nit1995/reimagined-enigma/Prototype/PCB/MEGA_2560 BOARD/CAMOutputs/Assembly/PnP_Motherboard Schematics - 1 - 29_Dec_2020_front.txt

C12	124.84	44.83	90.00		C1206
C13	125.35	26.29	180.00		C1206
C16	124.33	8.64	90.00		C1206
C17	124.33	-9.27	180.00		C1206
C19	127.00	-19.56	0.00		C1206
C2	123.11	40.26	0.00		C1206
C22	120.62	49.53	0.00	0.1uF	C1206
C23	117.75	34.93	0.00	0.1uF	C1206
C26	118.11	10.29	0.00		C1206
C27	120.65	-1.40	0.00		C1206
C29	115.82	-22.23	0.00		C1206
C3	125.32	30.61	270.00		C1206
C39	36.07	-15.75	90.00	0.1uF	C1206
C6	117.98	5.46	0.00		C1206
C7	129.03	-9.14	270.00		C1206
C79	36.20	-21.59	90.00	0.1uF	C1206
C9	116.08	-17.65	0.00		C1206
C90	11.81	33.76	270.00	0.1uF	C1206
D12	121.97	44.88	90.00	1N4148W	DO214AC
D13	121.29	27.69	90.00	1N4148W	DO214AC
D16	122.00	9.75	90.00	1N4148W	DO214AC
D18	119.96	-9.42	270.00	1N4148W	DO214AC
D19	127.89	-16.05	0.00	1N4148W	DO214AC
D2	126.42	37.67	180.00	1N4148W	DO214AC
D3	120.75	32.46	0.00	1N4148W	DO214AC
D6	124.46	4.29	0.00	1N4148W	DO214AC
D7	124.66	-12.14	180.00	1N4148W	DO214AC
D9	118.29	-15.14	0.00	1N4148W	DO214AC
LED1	43.15	-28.30	90.00		CHIPLED_1206
LED10	13.00	16.89	90.00		CHIPLED_1206
LED11	26.64	45.34	90.00		CHIPLED_1206
LED12	18.39	40.21	90.00		CHIPLED_1206
LED13	120.40	79.63	0.00		CHIPLED_1206
LED14	128.14	91.82	0.00		CHIPLED_1206
LED15	110.49	92.20	270.00		CHIPLED_1206
LED16	103.76	61.09	270.00		CHIPLED_1206
LED2	51.94	-10.11	270.00		CHIPLED_1206
LED3	49.40	6.22	90.00		CHIPLED_1206
LED4	39.07	6.05	90.00		CHIPLED_1206
LED5	38.53	11.81	90.00		CHIPLED_1206
LED6	48.87	21.89	90.00		CHIPLED_1206
LED7	37.85	35.31	90.00		CHIPLED_1206
LED8	49.40	35.31	90.00		CHIPLED_1206
LED9	20.27	18.19	180.00		CHIPLED_1206
R12	119.38	44.32	90.00	1k	R1206
R13	116.18	30.35	90.00	1k	R1206
R16	118.11	8.13	180.00	1k	R1206
R17	120.02	-4.57	180.00	1k	R1206
R19	116.08	-19.94	180.00	1k	R1206
R2	127.25	45.09	270.00	1k	R1206
R22	129.67	45.09	90.00	10k	R1206
R23	130.02	30.45	90.00	10k	R1206
R26	128.91	8.64	90.00	10k	R1206
R27	125.98	-5.59	90.00	10k	R1206
R3	127.76	30.61	270.00	1k	R1206
R30	121.79	-19.81	180.00	10k	R1206
R32	43.51	-25.73	180.00	10k	R1206
R34	38.99	-11.94	0.00	10k	R1206
R35	57.56	-10.01	0.00	10k	R1206
R36	57.58	-5.79	180.00	10k	R1206
R37	42.72	-6.71	180.00	10k	R1206
R39	49.10	9.47	180.00	10k	R1206
R40	42.16	23.29	180.00	10k	R1206
R42	31.47	24.23	90.00	10k	R1206
R43	21.64	11.30	270.00	10k	R1206
R44	32.74	29.97	270.00	10k	R1206
R47	47.83	-11.63	270.00	10k	R1206
R50	53.59	7.62	90.00	10k	R1206
R53	44.20	7.49	270.00	10k	R1206
R56	38.61	9.14	180.00	10k	R1206
R59	54.18	21.89	0.00	10k	R1206
R6	126.49	8.64	270.00	1k	R1206
R62	43.31	35.31	0.00	10k	R1206
R65	49.61	37.67	180.00	10k	R1206
R68	13.00	19.41	180.00	10k	R1206
R7	123.70	-5.46	270.00	1k	R1206
R71	17.17	17.91	90.00	10k	R1206
R74	31.98	45.31	0.00	10k	R1206
R77	22.40	41.12	90.00	10k	R1206
R79	123.57	79.38	90.00	1k	R1206
R80	131.06	91.82	90.00	1k	R1206
R81	105.92	90.68	270.00	1k	R1206
R83	97.16	61.21	180.00	1k	R1206
R9	121.79	-17.65	0.00	1k	R1206
