nit1995/reimagined-enigma/Prototype/PCB/MEGA_2560 BOARD/CAMOutputs/Assembly/Motherboard Schematics - 1 - 29_Dec_2020.txt

Partlist exported from G:/vinay projects/MEGA_2560 BOARD/Motherboard Schematics - 1 - 29_Dec_2020.sch at 05-01-2021 00:07

Qty Value                               Device                              Package                                   Parts                                                                                                                                                                                                                                                                                            Description                                                             ARROW_PART_NUMBER ARROW_PRICE-STOCK                                             AVAILABILITY DESCRIPTION                                                                                                  HEIGHT MANUFACTURER_NAME MANUFACTURER_PART_NUMBER MF       MOUSER_PART_NUMBER MOUSER_PRICE-STOCK                                                                     MP                                 MPN          OC_FARNELL OC_NEWARK PACKAGE  POPULARITY PRICE PURCHASE-URL                                                SPICEPREFIX
1                                       10-XX                               B3F-10XX                                  RESET_SW                                                                                                                                                                                                                                                                                         OMRON SWITCH                                                                                                                                                                                                                                                                                                                                                                                                                                                                              B3F-1000     176432     36M3542            72                                                                                      
25                                      C-EUC1206                           C1206                                     C1, C2, C3, C4, C5, C6, C7, C8, C9, C10, C11, C12, C13, C14, C15, C16, C17, C18, C19, C20, C26, C27, C28, C29, C30                                                                                                                                                                               CAPACITOR, European symbol                                                                                                                                                                                                                                                                                                                                                                                                                                                                                                           54                                                                           C          
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
7   220uF                               CPOL-EUE5-10.5                      E5-10,5                                   C32, C36, C40, C60, C75, C76, C77                                                                                                                                                                                                                                                                POLARIZED CAPACITOR, European symbol                                                                                                                                                                                                                                                                                                                                                                                                                                                                                                 23                                                                           C          
9   5mmTerminal_Block                   TERMINAL-BLOCK-3.5MM-2-PIN-LONG-PAD TERMINAL-BLOCK-2-PIN-3.5MM-LONG-PAD       X1, X2, X3, X6, X7, X8, X9, X10, X11                                                                                                                                                                                                                                                             Terminal Block 3.5mm                                                                                                                                                                                                                                                                                                                                                                                                                                                                                                                                                                                                         
2   7805DT                              7805DT                              TO252                                     IC2, IC3                                                                                                                                                                                                                                                                                         Positive VOLTAGE REGULATOR                                                                                                                                                                                                                                                                                                                                                                                                                                                                                                           0                                                                                       
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
12  MCT2E                               MCT2E                               DIP762W60P254L712H480Q6N                  IC1, IC4, IC5, IC6, IC7, IC8, IC9, IC10, IC11, IC12, IC13, IC14                                                                                                                                                                                                                                  Transistor Output Optocouplers Optocouplers                             MCT2E             https://www.arrow.com/en/products/mct2e/everlight-electronics              Transistor Output Optocouplers Optocouplers                                                                  4.8mm  Everlight         MCT2E                             638-MCT2E          https://www.mouser.co.uk/ProductDetail/Everlight/MCT2E?qs=8PzhAHr7IdNay24oEWwF1g%3D%3D                                                                                                                                                                       
1   MEGA_PRO_EMBED_CH340G_/_ATMEGA2560  MEGA_PRO_EMBED_CH340G_/_ATMEGA2560  MODULE_MEGA_PRO_EMBED_CH340G_/_ATMEGA2560 U1                                                                                                                                                                                                                                                                                               Mega 2560 PRO (Embed) CH340G/ATmega2560-16AU                                                                                                            Unavailable                                                                                                                                                                 Robotdyn                                                                                                           Mega Pro Embed CH340G / ATmega2560                                   Package             None                                                                         
1   RS485-TTL-CONVERTER                 RS485-TTL-CONVERTER                 RS485-TTL-CONVERTER                       U$2                                                                                                                                                                                                                                                                                              RS485 to TTL converter based on MAX485 chip                                                                                                                                                                                                                                                                                                                                                                                                                                                                                                                                                                                  
1   RTC-DS3231-AT24C32                  RTC-DS3231-AT24C32                  RTC-DS3231-AT24C32                        U$1                                                                                                                                                                                                                                                                                              RTC Module with Battery and EEPROM based on DS3231 and AT24C32 chips                                                                                                                                                                                                                                                                                                                                                                                                                                                                                                                                                         
1   SPPH410100                          SPPH410100                          SPPH410100                                SW                                                                                                                                                                                                                                                                                               Check prices                                                                                                                                            Good          Ring Type Encoder (ABC - three phase) • Number of Detent: 30 • Number of Pulse: 10 • Actuator Length: 15mm                                                    ALPS                                                                                                               SPPH410100                                                           None                None  https://pricing.snapeda.com/search/part/SPPH410100/?ref=eda            
1   SWITCH_I                            SWITCH_I                            SWITCH_I                                  SWITCH                                                                                                                                                                                                                                                                                                                                                                                                                                                                                                                                                                                                                                                                                                                                                                                                                                                                                                                        
8   TERMINAL-BLOCK-3.5MM-2-PIN-LONG-PAD TERMINAL-BLOCK-3.5MM-2-PIN-LONG-PAD TERMINAL-BLOCK-2-PIN-3.5MM-LONG-PAD       X5, X12, X13, X14, X15, X16, X17, X18                                                                                                                                                                                                                                                            Terminal Block 3.5mm                                                                                                                                                                                                                                                                                                                                                                                                                                                                                                                                                                                                         
1   TERMINAL_BLOCK                      TERMINAL_BLOCK                      BOC_TERMINAL                              T1
