nit1995/reimagined-enigma/Prototype/PCB/MEGA_2560 BOARD/Image_bottomlayer.png

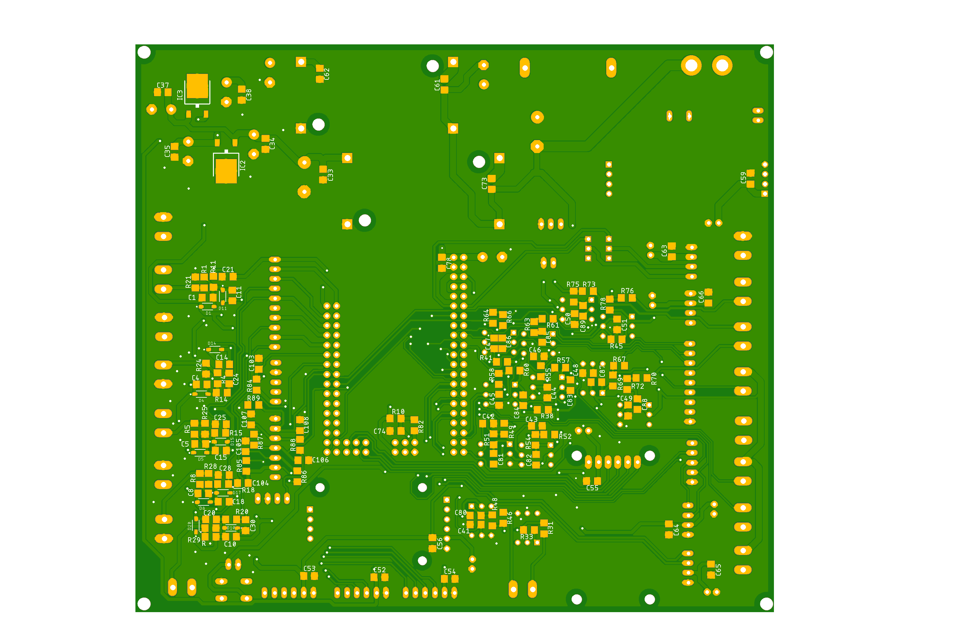
Prototype/PCB/MEGA_2560 BOARD/Image_bottomlayer.png
