nit1995/reimagined-enigma/Prototype/PCB/MEGA_2560 BOARD/image_toplayer.png

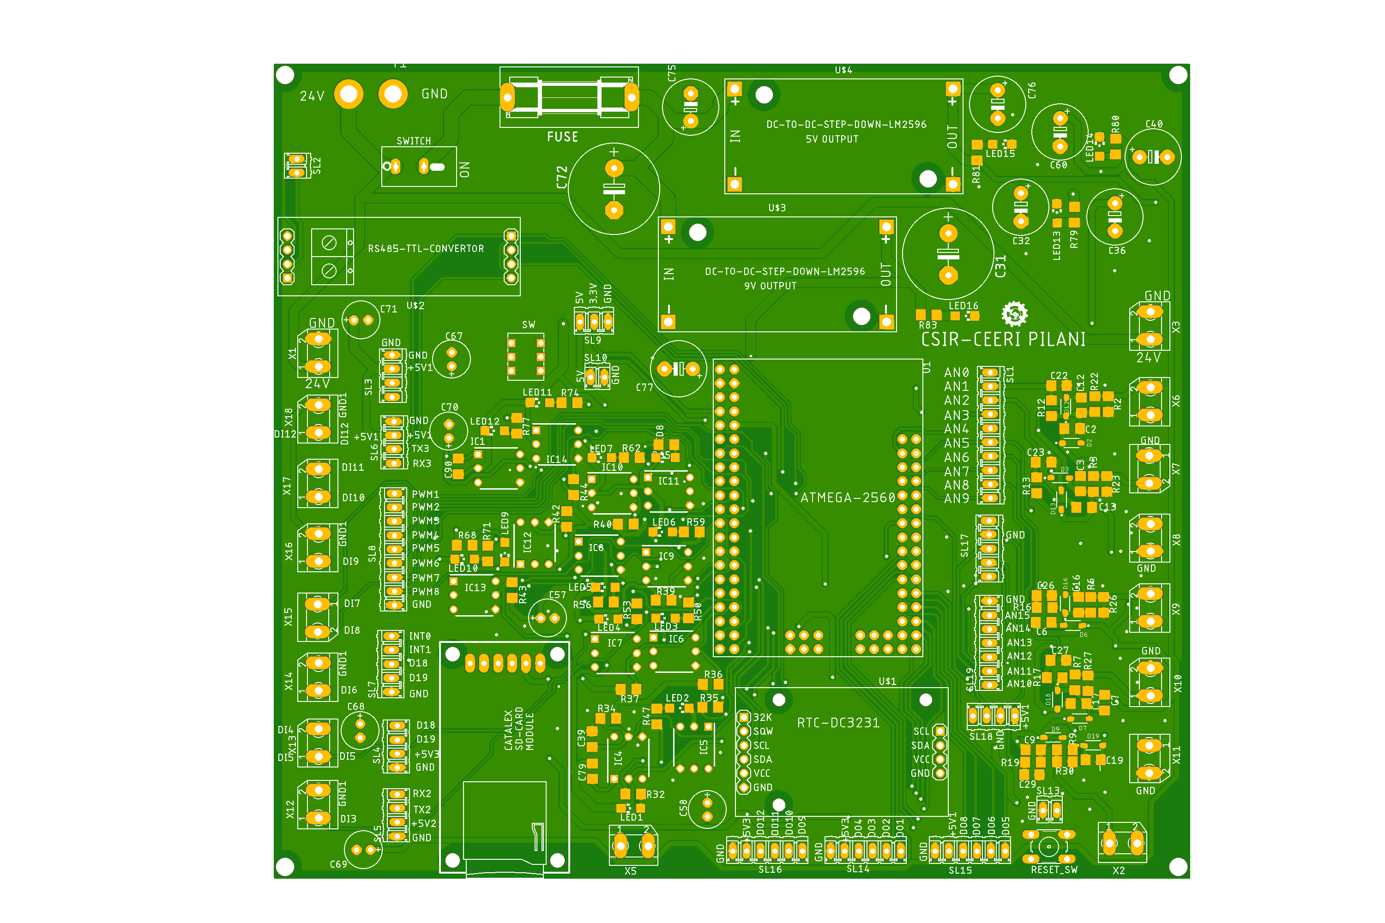
Prototype/PCB/MEGA_2560 BOARD/image_toplayer.png
