nit1995/reimagined-enigma/Prototype/PCB/MEGA_2560 BOARD/BOM 28-1-21.csv

Part | Value | Device | Package | Description | ARROW_PART_NUMBER | ARROW_PRICE-STOCK | AVAILABILITY | DESCRIPTION | HEIGHT | MANUFACTURER_NAME | MANUFACTURER_PART_NUMBER | MF | MOUSER_PART_NUMBER | MOUSER_PRICE-STOCK | MP | MPN | OC_FARNELL | OC_NEWARK | PACKAGE | POPULARITY | PRICE | PURCHASE-URL | SPICEPREFIX
C1 |  | C-EUC1206 | C1206 | CAPACITOR, European symbol |  |  |  |  |  |  |  |  |  |  |  |  |  |  |  | 54 |  |  | C
C2 |  | C-EUC1206 | C1206 | CAPACITOR, European symbol |  |  |  |  |  |  |  |  |  |  |  |  |  |  |  | 54 |  |  | C
C3 |  | C-EUC1206 | C1206 | CAPACITOR, European symbol |  |  |  |  |  |  |  |  |  |  |  |  |  |  |  | 54 |  |  | C
C4 |  | C-EUC1206 | C1206 | CAPACITOR, European symbol |  |  |  |  |  |  |  |  |  |  |  |  |  |  |  | 54 |  |  | C
C5 |  | C-EUC1206 | C1206 | CAPACITOR, European symbol |  |  |  |  |  |  |  |  |  |  |  |  |  |  |  | 54 |  |  | C
C6 |  | C-EUC1206 | C1206 | CAPACITOR, European symbol |  |  |  |  |  |  |  |  |  |  |  |  |  |  |  | 54 |  |  | C
C7 |  | C-EUC1206 | C1206 | CAPACITOR, European symbol |  |  |  |  |  |  |  |  |  |  |  |  |  |  |  | 54 |  |  | C
C8 |  | C-EUC1206 | C1206 | CAPACITOR, European symbol |  |  |  |  |  |  |  |  |  |  |  |  |  |  |  | 54 |  |  | C
C9 |  | C-EUC1206 | C1206 | CAPACITOR, European symbol |  |  |  |  |  |  |  |  |  |  |  |  |  |  |  | 54 |  |  | C
C10 |  | C-EUC1206 | C1206 | CAPACITOR, European symbol |  |  |  |  |  |  |  |  |  |  |  |  |  |  |  | 54 |  |  | C
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
C105 | 0.1uF | C-EUC1206 | C1206 | CAPACITOR, European symbol |  |  |  |  |  |  |  |  |  |  |  |  |  |  |  | 54 |  |  | C
C106 | 0.1uF | C-EUC1206 | C1206 | CAPACITOR, European symbol |  |  |  |  |  |  |  |  |  |  |  |  |  |  |  | 54 |  |  | C
C107 | 0.1uF | C-EUC1206 | C1206 | CAPACITOR, European symbol |  |  |  |  |  |  |  |  |  |  |  |  |  |  |  | 54 |  |  | C
C108 | 0.1uF | C-EUC1206 | C1206 | CAPACITOR, European symbol |  |  |  |  |  |  |  |  |  |  |  |  |  |  |  | 54 |  |  | C
D1 | 1N4148W | DIODE-DO214AC | DO214AC | DIODE |  |  |  |  |  |  |  |  |  |  |  |  |  |  |  | 14
D2 | 1N4148W | DIODE-DO214AC | DO214AC | DIODE |  |  |  |  |  |  |  |  |  |  |  |  |  |  |  | 14
D3 | 1N4148W | DIODE-DO214AC | DO214AC | DIODE |  |  |  |  |  |  |  |  |  |  |  |  |  |  |  | 14
D4 | 1N4148W | DIODE-DO214AC | DO214AC | DIODE |  |  |  |  |  |  |  |  |  |  |  |  |  |  |  | 14
D5 | 1N4148W | DIODE-DO214AC | DO214AC | DIODE |  |  |  |  |  |  |  |  |  |  |  |  |  |  |  | 14
D6 | 1N4148W | DIODE-DO214AC | DO214AC | DIODE |  |  |  |  |  |  |  |  |  |  |  |  |  |  |  | 14
D7 | 1N4148W | DIODE-DO214AC | DO214AC | DIODE |  |  |  |  |  |  |  |  |  |  |  |  |  |  |  | 14
D8 | 1N4148W | DIODE-DO214AC | DO214AC | DIODE |  |  |  |  |  |  |  |  |  |  |  |  |  |  |  | 14
D9 | 1N4148W | DIODE-DO214AC | DO214AC | DIODE |  |  |  |  |  |  |  |  |  |  |  |  |  |  |  | 14
D10 | 1N4148W | DIODE-DO214AC | DO214AC | DIODE |  |  |  |  |  |  |  |  |  |  |  |  |  |  |  | 14
D11 | 1N4148W | DIODE-DO214AC | DO214AC | DIODE |  |  |  |  |  |  |  |  |  |  |  |  |  |  |  | 14
D12 | 1N4148W | DIODE-DO214AC | DO214AC | DIODE |  |  |  |  |  |  |  |  |  |  |  |  |  |  |  | 14
D13 | 1N4148W | DIODE-DO214AC | DO214AC | DIODE |  |  |  |  |  |  |  |  |  |  |  |  |  |  |  | 14
D14. | 1N4148W | DIODE-DO214AC | DO214AC | DIODE |  |  |  |  |  |  |  |  |  |  |  |  |  |  |  | 14
D15 | 1N4148W | DIODE-DO214AC | DO214AC | DIODE |  |  |  |  |  |  |  |  |  |  |  |  |  |  |  | 14
D16 | 1N4148W | DIODE-DO214AC | DO214AC | DIODE |  |  |  |  |  |  |  |  |  |  |  |  |  |  |  | 14
D17 | 1N4148W | DIODE-DO214AC | DO214AC | DIODE |  |  |  |  |  |  |  |  |  |  |  |  |  |  |  | 14
D18 | 1N4148W | DIODE-DO214AC | DO214AC | DIODE |  |  |  |  |  |  |  |  |  |  |  |  |  |  |  | 14
D19 | 1N4148W | DIODE-DO214AC | DO214AC | DIODE |  |  |  |  |  |  |  |  |  |  |  |  |  |  |  | 14
D20 | 1N4148W | DIODE-DO214AC | DO214AC | DIODE |  |  |  |  |  |  |  |  |  |  |  |  |  |  |  | 14
FUSE |  | SH22,5A | SH22,5A | FUSE HOLDER grid 22,5mm, isolated cap OGN0031 8201, Schurter (Buerklin) |  |  |  |  |  |  |  |  |  |  |  | 0031.7701.11 | unknown | 04F1224 |  | 0
IC1 | MCT2E | MCT2E | DIP762W60P254L712H480Q6N | Transistor Output Optocouplers Optocouplers | MCT2E | https://www.arrow.com/en/products/mct2e/everlight-electronics |  | Transistor Output Optocouplers Optocouplers | 4.8mm | Everlight | MCT2E |  | 638-MCT2E | https://www.mouser.co.uk/ProductDetail/Everlight/MCT2E?qs=8PzhAHr7IdNay24oEWwF1g%3D%3D
IC2 | 7805DT | 7805DT | TO252 | Positive VOLTAGE REGULATOR |  |  |  |  |  |  |  |  |  |  |  |  |  |  |  | 0
IC3 | 7805DT | 7805DT | TO252 | Positive VOLTAGE REGULATOR |  |  |  |  |  |  |  |  |  |  |  |  |  |  |  | 0
IC4 | MCT2E | MCT2E | DIP762W60P254L712H480Q6N | Transistor Output Optocouplers Optocouplers | MCT2E | https://www.arrow.com/en/products/mct2e/everlight-electronics |  | Transistor Output Optocouplers Optocouplers | 4.8mm | Everlight | MCT2E |  | 638-MCT2E | https://www.mouser.co.uk/ProductDetail/Everlight/MCT2E?qs=8PzhAHr7IdNay24oEWwF1g%3D%3D
IC5 | MCT2E | MCT2E | DIP762W60P254L712H480Q6N | Transistor Output Optocouplers Optocouplers | MCT2E | https://www.arrow.com/en/products/mct2e/everlight-electronics |  | Transistor Output Optocouplers Optocouplers | 4.8mm | Everlight | MCT2E |  | 638-MCT2E | https://www.mouser.co.uk/ProductDetail/Everlight/MCT2E?qs=8PzhAHr7IdNay24oEWwF1g%3D%3D
IC6 | MCT2E | MCT2E | DIP762W60P254L712H480Q6N | Transistor Output Optocouplers Optocouplers | MCT2E | https://www.arrow.com/en/products/mct2e/everlight-electronics |  | Transistor Output Optocouplers Optocouplers | 4.8mm | Everlight | MCT2E |  | 638-MCT2E | https://www.mouser.co.uk/ProductDetail/Everlight/MCT2E?qs=8PzhAHr7IdNay24oEWwF1g%3D%3D
IC7 | MCT2E | MCT2E | DIP762W60P254L712H480Q6N | Transistor Output Optocouplers Optocouplers | MCT2E | https://www.arrow.com/en/products/mct2e/everlight-electronics |  | Transistor Output Optocouplers Optocouplers | 4.8mm | Everlight | MCT2E |  | 638-MCT2E | https://www.mouser.co.uk/ProductDetail/Everlight/MCT2E?qs=8PzhAHr7IdNay24oEWwF1g%3D%3D
IC8 | MCT2E | MCT2E | DIP762W60P254L712H480Q6N | Transistor Output Optocouplers Optocouplers | MCT2E | https://www.arrow.com/en/products/mct2e/everlight-electronics |  | Transistor Output Optocouplers Optocouplers | 4.8mm | Everlight | MCT2E |  | 638-MCT2E | https://www.mouser.co.uk/ProductDetail/Everlight/MCT2E?qs=8PzhAHr7IdNay24oEWwF1g%3D%3D
IC9 | MCT2E | MCT2E | DIP762W60P254L712H480Q6N | Transistor Output Optocouplers Optocouplers | MCT2E | https://www.arrow.com/en/products/mct2e/everlight-electronics |  | Transistor Output Optocouplers Optocouplers | 4.8mm | Everlight | MCT2E |  | 638-MCT2E | https://www.mouser.co.uk/ProductDetail/Everlight/MCT2E?qs=8PzhAHr7IdNay24oEWwF1g%3D%3D
IC10 | MCT2E | MCT2E | DIP762W60P254L712H480Q6N | Transistor Output Optocouplers Optocouplers | MCT2E | https://www.arrow.com/en/products/mct2e/everlight-electronics |  | Transistor Output Optocouplers Optocouplers | 4.8mm | Everlight | MCT2E |  | 638-MCT2E | https://www.mouser.co.uk/ProductDetail/Everlight/MCT2E?qs=8PzhAHr7IdNay24oEWwF1g%3D%3D
IC11 | MCT2E | MCT2E | DIP762W60P254L712H480Q6N | Transistor Output Optocouplers Optocouplers | MCT2E | https://www.arrow.com/en/products/mct2e/everlight-electronics |  | Transistor Output Optocouplers Optocouplers | 4.8mm | Everlight | MCT2E |  | 638-MCT2E | https://www.mouser.co.uk/ProductDetail/Everlight/MCT2E?qs=8PzhAHr7IdNay24oEWwF1g%3D%3D
IC12 | MCT2E | MCT2E | DIP762W60P254L712H480Q6N | Transistor Output Optocouplers Optocouplers | MCT2E | https://www.arrow.com/en/products/mct2e/everlight-electronics |  | Transistor Output Optocouplers Optocouplers | 4.8mm | Everlight | MCT2E |  | 638-MCT2E | https://www.mouser.co.uk/ProductDetail/Everlight/MCT2E?qs=8PzhAHr7IdNay24oEWwF1g%3D%3D
IC13 | MCT2E | MCT2E | DIP762W60P254L712H480Q6N | Transistor Output Optocouplers Optocouplers | MCT2E | https://www.arrow.com/en/products/mct2e/everlight-electronics |  | Transistor Output Optocouplers Optocouplers | 4.8mm | Everlight | MCT2E |  | 638-MCT2E | https://www.mouser.co.uk/ProductDetail/Everlight/MCT2E?qs=8PzhAHr7IdNay24oEWwF1g%3D%3D
IC14 | MCT2E | MCT2E | DIP762W60P254L712H480Q6N | Transistor Output Optocouplers Optocouplers | MCT2E | https://www.arrow.com/en/products/mct2e/everlight-electronics |  | Transistor Output Optocouplers Optocouplers | 4.8mm | Everlight | MCT2E |  | 638-MCT2E | https://www.mouser.co.uk/ProductDetail/Everlight/MCT2E?qs=8PzhAHr7IdNay24oEWwF1g%3D%3D
LED1 |  | LEDCHIPLED_1206 | CHIPLED_1206 | LED |  |  |  |  |  |  |  |  |  |  |  |  |  |  |  | 28
LED2 |  | LEDCHIPLED_1206 | CHIPLED_1206 | LED |  |  |  |  |  |  |  |  |  |  |  |  |  |  |  | 28
LED3 |  | LEDCHIPLED_1206 | CHIPLED_1206 | LED |  |  |  |  |  |  |  |  |  |  |  |  |  |  |  | 28
LED4 |  | LEDCHIPLED_1206 | CHIPLED_1206 | LED |  |  |  |  |  |  |  |  |  |  |  |  |  |  |  | 28
LED5 |  | LEDCHIPLED_1206 | CHIPLED_1206 | LED |  |  |  |  |  |  |  |  |  |  |  |  |  |  |  | 28
LED6 |  | LEDCHIPLED_1206 | CHIPLED_1206 | LED |  |  |  |  |  |  |  |  |  |  |  |  |  |  |  | 28
LED7 |  | LEDCHIPLED_1206 | CHIPLED_1206 | LED |  |  |  |  |  |  |  |  |  |  |  |  |  |  |  | 28
LED8 |  | LEDCHIPLED_1206 | CHIPLED_1206 | LED |  |  |  |  |  |  |  |  |  |  |  |  |  |  |  | 28
LED9 |  | LEDCHIPLED_1206 | CHIPLED_1206 | LED |  |  |  |  |  |  |  |  |  |  |  |  |  |  |  | 28
LED10 |  | LEDCHIPLED_1206 | CHIPLED_1206 | LED |  |  |  |  |  |  |  |  |  |  |  |  |  |  |  | 28
LED11 |  | LEDCHIPLED_1206 | CHIPLED_1206 | LED |  |  |  |  |  |  |  |  |  |  |  |  |  |  |  | 28
LED12 |  | LEDCHIPLED_1206 | CHIPLED_1206 | LED |  |  |  |  |  |  |  |  |  |  |  |  |  |  |  | 28
LED13 |  | LEDCHIPLED_1206 | CHIPLED_1206 | LED |  |  |  |  |  |  |  |  |  |  |  |  |  |  |  | 28
LED14 |  | LEDCHIPLED_1206 | CHIPLED_1206 | LED |  |  |  |  |  |  |  |  |  |  |  |  |  |  |  | 28
LED15 |  | LEDCHIPLED_1206 | CHIPLED_1206 | LED |  |  |  |  |  |  |  |  |  |  |  |  |  |  |  | 28
LED16 |  | LEDCHIPLED_1206 | CHIPLED_1206 | LED |  |  |  |  |  |  |  |  |  |  |  |  |  |  |  | 28
MOD1 | CARD-SD-ADAPTER-CATALEX | CARD-SD-ADAPTER-CATALEX | CARD-SD-ADAPTER-CATALEX | Micro SD Card Adapter Module with onboard 3.3V regulator
R | 1k | R-US_R1206 | R1206 | RESISTOR, American symbol |  |  |  |  |  |  |  |  |  |  |  |  |  |  |  | 19 |  |  | R
R1 | 1k | R-US_R1206 | R1206 | RESISTOR, American symbol |  |  |  |  |  |  |  |  |  |  |  |  |  |  |  |  |  |  | R
R2 | 1k | R-US_R1206 | R1206 | RESISTOR, American symbol |  |  |  |  |  |  |  |  |  |  |  |  |  |  |  | 19 |  |  | R
R3 | 1k | R-US_R1206 | R1206 | RESISTOR, American symbol |  |  |  |  |  |  |  |  |  |  |  |  |  |  |  | 19 |  |  | R
R4 | 1k | R-US_R1206 | R1206 | RESISTOR, American symbol |  |  |  |  |  |  |  |  |  |  |  |  |  |  |  | 19 |  |  | R
R5 | 1k | R-US_R1206 | R1206 | RESISTOR, American symbol |  |  |  |  |  |  |  |  |  |  |  |  |  |  |  | 19 |  |  | R
R6 | 1k | R-US_R1206 | R1206 | RESISTOR, American symbol |  |  |  |  |  |  |  |  |  |  |  |  |  |  |  | 19 |  |  | R
R7 | 1k | R-US_R1206 | R1206 | RESISTOR, American symbol |  |  |  |  |  |  |  |  |  |  |  |  |  |  |  | 19 |  |  | R
R8 | 1k | R-US_R1206 | R1206 | RESISTOR, American symbol |  |  |  |  |  |  |  |  |  |  |  |  |  |  |  | 19 |  |  | R
R9 | 1k | R-US_R1206 | R1206 | RESISTOR, American symbol |  |  |  |  |  |  |  |  |  |  |  |  |  |  |  | 19 |  |  | R
R10 | 10k | R-US_R1206 | R1206 | RESISTOR, American symbol |  |  |  |  |  |  |  |  |  |  |  |  |  |  |  |  |  |  | R
R11 | 1k | R-US_R1206 | R1206 | RESISTOR, American symbol |  |  |  |  |  |  |  |  |  |  |  |  |  |  |  | 19 |  |  | R
R12 | 1k | R-US_R1206 | R1206 | RESISTOR, American symbol |  |  |  |  |  |  |  |  |  |  |  |  |  |  |  | 19 |  |  | R
R13 | 1k | R-US_R1206 | R1206 | RESISTOR, American symbol |  |  |  |  |  |  |  |  |  |  |  |  |  |  |  | 19 |  |  | R
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
SL13 |  | M02 | 02P | AMP QUICK CONNECTOR |  |  |  |  |  |  |  |  |  |  |  |  | unknown | unknown |  | 33
SL14 |  | M06 | 06P | AMP QUICK CONNECTOR |  |  |  |  |  |  |  |  |  |  |  |  | unknown | unknown |  | 5
SL15 |  | M06 | 06P | AMP QUICK CONNECTOR |  |  |  |  |  |  |  |  |  |  |  |  | unknown | unknown |  | 5
SL16 |  | M06 | 06P | AMP QUICK CONNECTOR |  |  |  |  |  |  |  |  |  |  |  |  | unknown | unknown |  | 5
SL17 |  | M05 | 05P | AMP QUICK CONNECTOR |  |  |  |  |  |  |  |  |  |  |  |  | unknown | unknown |  | 16
SL18 |  | M04 | 04P | AMP QUICK CONNECTOR |  |  |  |  |  |  |  |  |  |  |  |  | unknown | unknown |  | 19
SL19 |  | M07S | 07P | AMP QUICK CONNECTOR |  |  |  |  |  |  |  |  |  |  |  |  | unknown | unknown |  | 0
SW | SPPH410100 | SPPH410100 | SPPH410100 | Check prices |  |  | Good | Ring Type Encoder (ABC - three phase) • Number of Detent: 30 • Number of Pulse: 10 • Actuator Length: 15mm |  |  |  | ALPS |  |  | SPPH410100 |  |  |  | None |  | None | https://pricing.snapeda.com/search/part/SPPH410100/?ref=eda
SWITCH | SWITCH_I | SWITCH_I | SWITCH_I
T1 | TERMINAL_BLOCK | TERMINAL_BLOCK | BOC_TERMINAL
U$1 | RTC-DS3231-AT24C32 | RTC-DS3231-AT24C32 | RTC-DS3231-AT24C32 | RTC Module with Battery and EEPROM based on DS3231 and AT24C32 chips
U$2 | RS485-TTL-CONVERTER | RS485-TTL-CONVERTER | RS485-TTL-CONVERTER | RS485 to TTL converter based on MAX485 chip
U$3 | DC-DC-STEP-DOWN-LM2596 | DC-DC-STEP-DOWN-LM2596 | DC-DC-STEP-DOWN-LM2596 | DC/DC Step-Down Regulator based on LM2596-ADJ chip
U$4 | DC-DC-STEP-DOWN-LM2596 | DC-DC-STEP-DOWN-LM2596 | DC-DC-STEP-DOWN-LM2596 | DC/DC Step-Down Regulator based on LM2596-ADJ chip
U$5 | CSIR_LOGO | CSIR_LOGO | CSIR_LOGO
U1 | MEGA_PRO_EMBED_CH340G_/_ATMEGA2560 | MEGA_PRO_EMBED_CH340G_/_ATMEGA2560 | MODULE_MEGA_PRO_EMBED_CH340G_/_ATMEGA2560 | Mega 2560 PRO (Embed) CH340G/ATmega2560-16AU |  |  | Unavailable |  |  |  |  | Robotdyn |  |  | Mega Pro Embed CH340G / ATmega2560 |  |  |  | Package |  | None
X1 | 5mmTerminal_Block | TERMINAL-BLOCK-3.5MM-2-PIN-LONG-PAD | TERMINAL-BLOCK-2-PIN-3.5MM-LONG-PAD | Terminal Block 3.5mm
X2 | 5mmTerminal_Block | TERMINAL-BLOCK-3.5MM-2-PIN-LONG-PAD | TERMINAL-BLOCK-2-PIN-3.5MM-LONG-PAD | Terminal Block 3.5mm
X3 | 5mmTerminal_Block | TERMINAL-BLOCK-3.5MM-2-PIN-LONG-PAD | TERMINAL-BLOCK-2-PIN-3.5MM-LONG-PAD | Terminal Block 3.5mm
X5 | TERMINAL-BLOCK-3.5MM-2-PIN-LONG-PAD | TERMINAL-BLOCK-3.5MM-2-PIN-LONG-PAD | TERMINAL-BLOCK-2-PIN-3.5MM-LONG-PAD | Terminal Block 3.5mm
X6 | 5mmTerminal_Block | TERMINAL-BLOCK-3.5MM-2-PIN-LONG-PAD | TERMINAL-BLOCK-2-PIN-3.5MM-LONG-PAD | Terminal Block 3.5mm
X7 | 5mmTerminal_Block | TERMINAL-BLOCK-3.5MM-2-PIN-LONG-PAD | TERMINAL-BLOCK-2-PIN-3.5MM-LONG-PAD | Terminal Block 3.5mm
X8 | 5mmTerminal_Block | TERMINAL-BLOCK-3.5MM-2-PIN-LONG-PAD | TERMINAL-BLOCK-2-PIN-3.5MM-LONG-PAD | Terminal Block 3.5mm
X9 | 5mmTerminal_Block | TERMINAL-BLOCK-3.5MM-2-PIN-LONG-PAD | TERMINAL-BLOCK-2-PIN-3.5MM-LONG-PAD | Terminal Block 3.5mm
X10 | 5mmTerminal_Block | TERMINAL-BLOCK-3.5MM-2-PIN-LONG-PAD | TERMINAL-BLOCK-2-PIN-3.5MM-LONG-PAD | Terminal Block 3.5mm
X11 | 5mmTerminal_Block | TERMINAL-BLOCK-3.5MM-2-PIN-LONG-PAD | TERMINAL-BLOCK-2-PIN-3.5MM-LONG-PAD | Terminal Block 3.5mm
X12 | TERMINAL-BLOCK-3.5MM-2-PIN-LONG-PAD | TERMINAL-BLOCK-3.5MM-2-PIN-LONG-PAD | TERMINAL-BLOCK-2-PIN-3.5MM-LONG-PAD | Terminal Block 3.5mm
X13 | TERMINAL-BLOCK-3.5MM-2-PIN-LONG-PAD | TERMINAL-BLOCK-3.5MM-2-PIN-LONG-PAD | TERMINAL-BLOCK-2-PIN-3.5MM-LONG-PAD | Terminal Block 3.5mm
X14 | TERMINAL-BLOCK-3.5MM-2-PIN-LONG-PAD | TERMINAL-BLOCK-3.5MM-2-PIN-LONG-PAD | TERMINAL-BLOCK-2-PIN-3.5MM-LONG-PAD | Terminal Block 3.5mm
X15 | TERMINAL-BLOCK-3.5MM-2-PIN-LONG-PAD | TERMINAL-BLOCK-3.5MM-2-PIN-LONG-PAD | TERMINAL-BLOCK-2-PIN-3.5MM-LONG-PAD | Terminal Block 3.5mm
X16 | TERMINAL-BLOCK-3.5MM-2-PIN-LONG-PAD | TERMINAL-BLOCK-3.5MM-2-PIN-LONG-PAD | TERMINAL-BLOCK-2-PIN-3.5MM-LONG-PAD | Terminal Block 3.5mm
X17 | TERMINAL-BLOCK-3.5MM-2-PIN-LONG-PAD | TERMINAL-BLOCK-3.5MM-2-PIN-LONG-PAD | TERMINAL-BLOCK-2-PIN-3.5MM-LONG-PAD | Terminal Block 3.5mm
X18 | TERMINAL-BLOCK-3.5MM-2-PIN-LONG-PAD | TERMINAL-BLOCK-3.5MM-2-PIN-LONG-PAD | TERMINAL-BLOCK-2-PIN-3.5MM-LONG-PAD | Terminal Block 3.5mm
