nit1995/reimagined-enigma/Prototype/PCB/MEGA_2560 BOARD/Motherboard Schematics - 1 - 29_Dec_2020.pdf

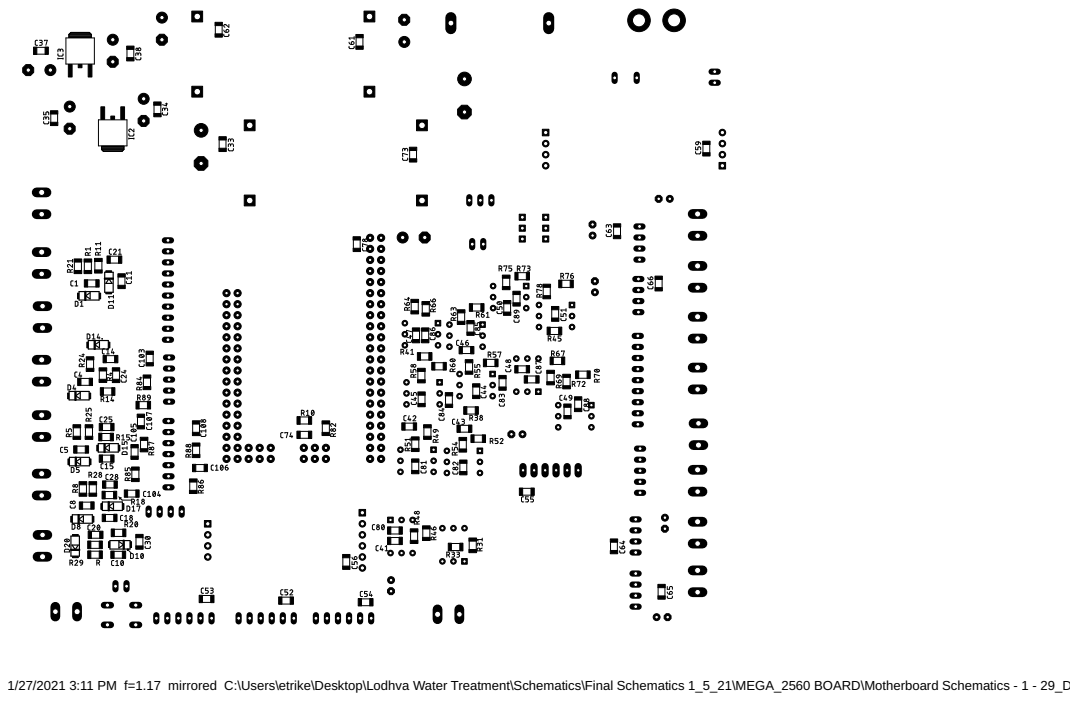
[picture p3: page 1]

1/27/2021 3:11 PM f=1.17 mirrored C:\Users\etrike\Desktop\Lodhva Water Treatment\Schematics\Final Schematics 1_5_21\MEGA_2560 BOARD\Motherboard Schematics - 1 - 29_Dec_2020.brd
