nit1995/reimagined-enigma/Prototype/PCB/MEGA_2560 BOARD/Motherboard Schematics - 1 - 29_Dec_2020.brd

## EAGLE design Prototype/PCB/MEGA_2560 BOARD/Motherboard Schematics - 1 - 29_Dec_2020.brd (2021-03-16)

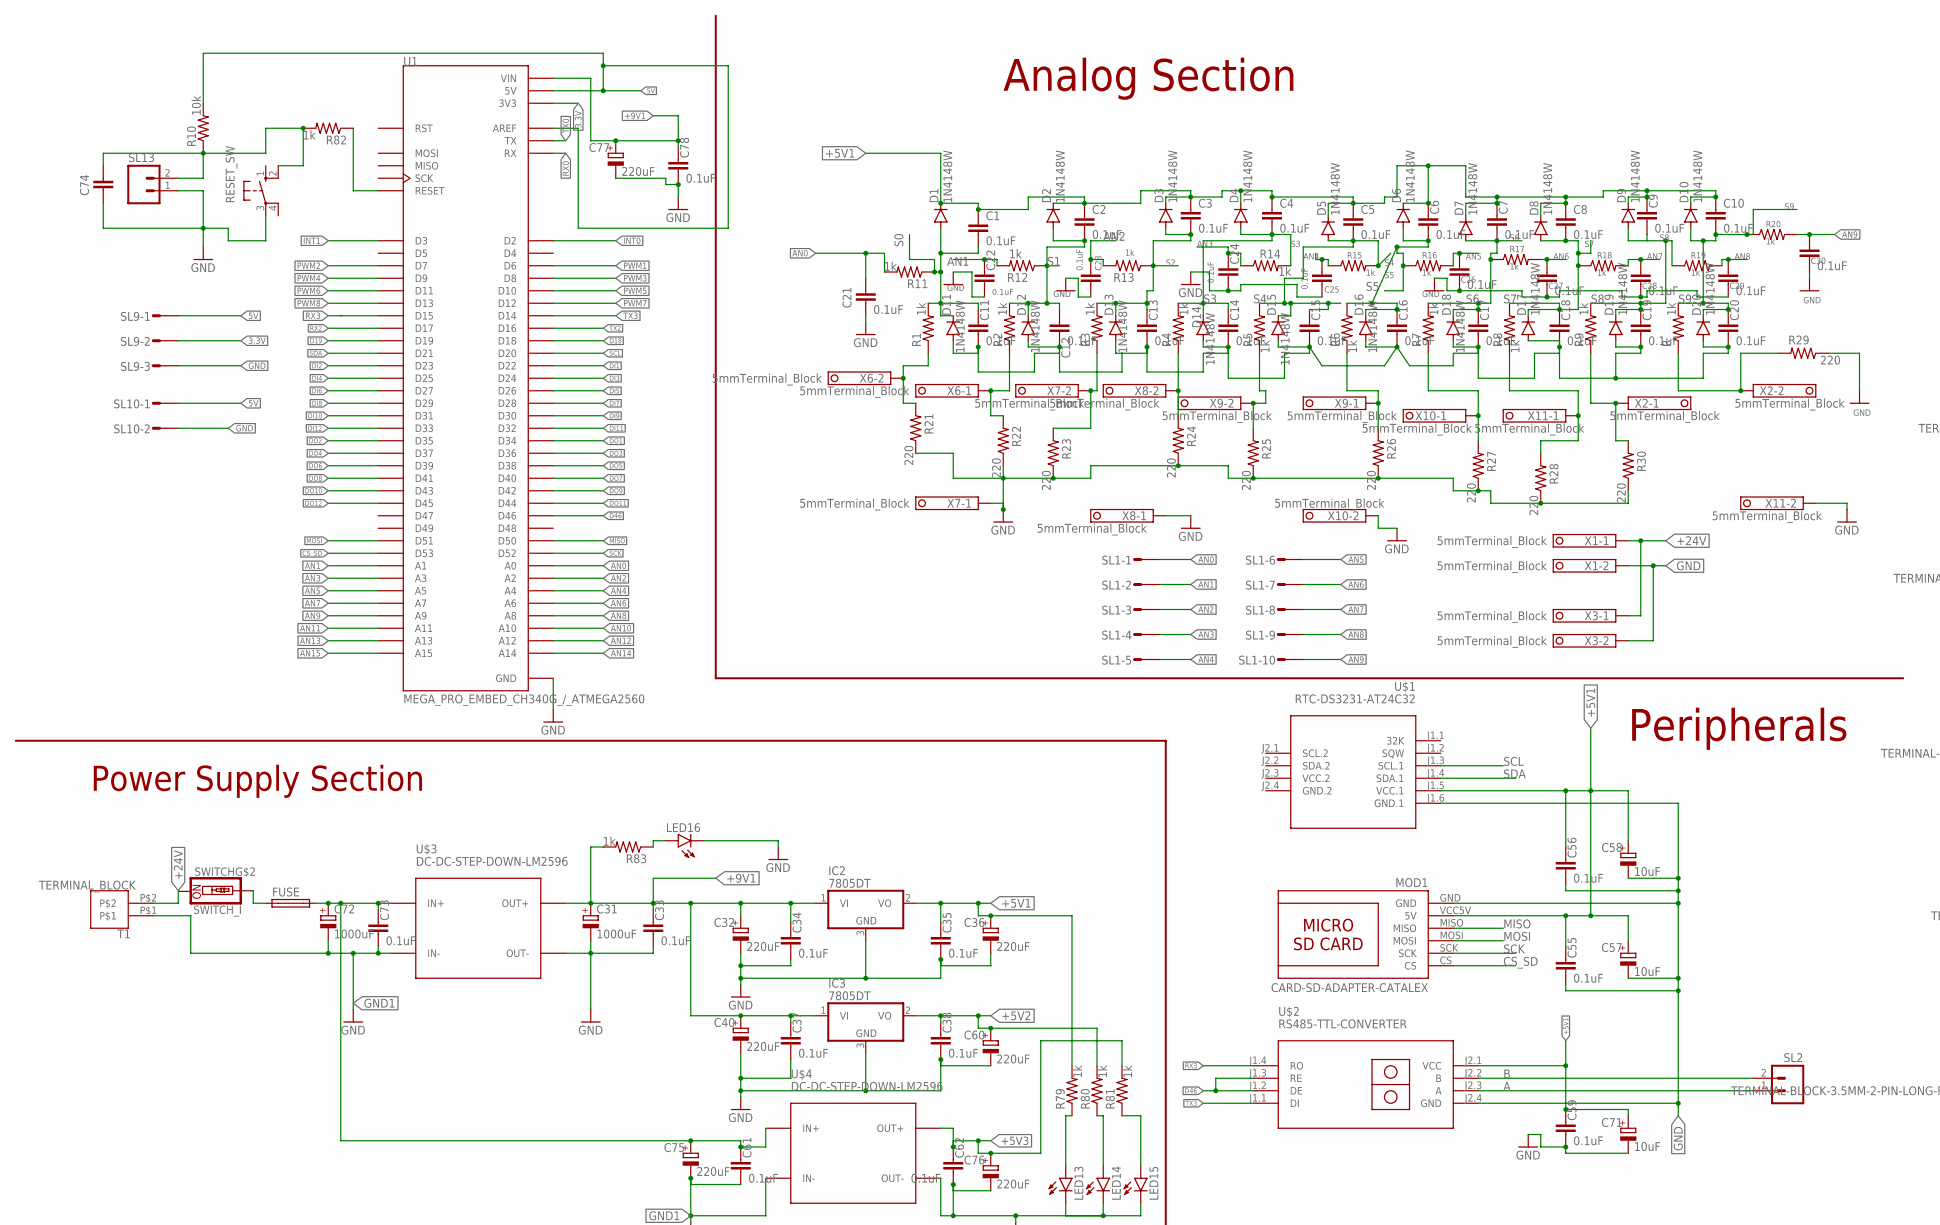
[picture p4: schematic Motherboard Schematics - 1 - 29_Dec_2020.sch, part in row 1, column 1]

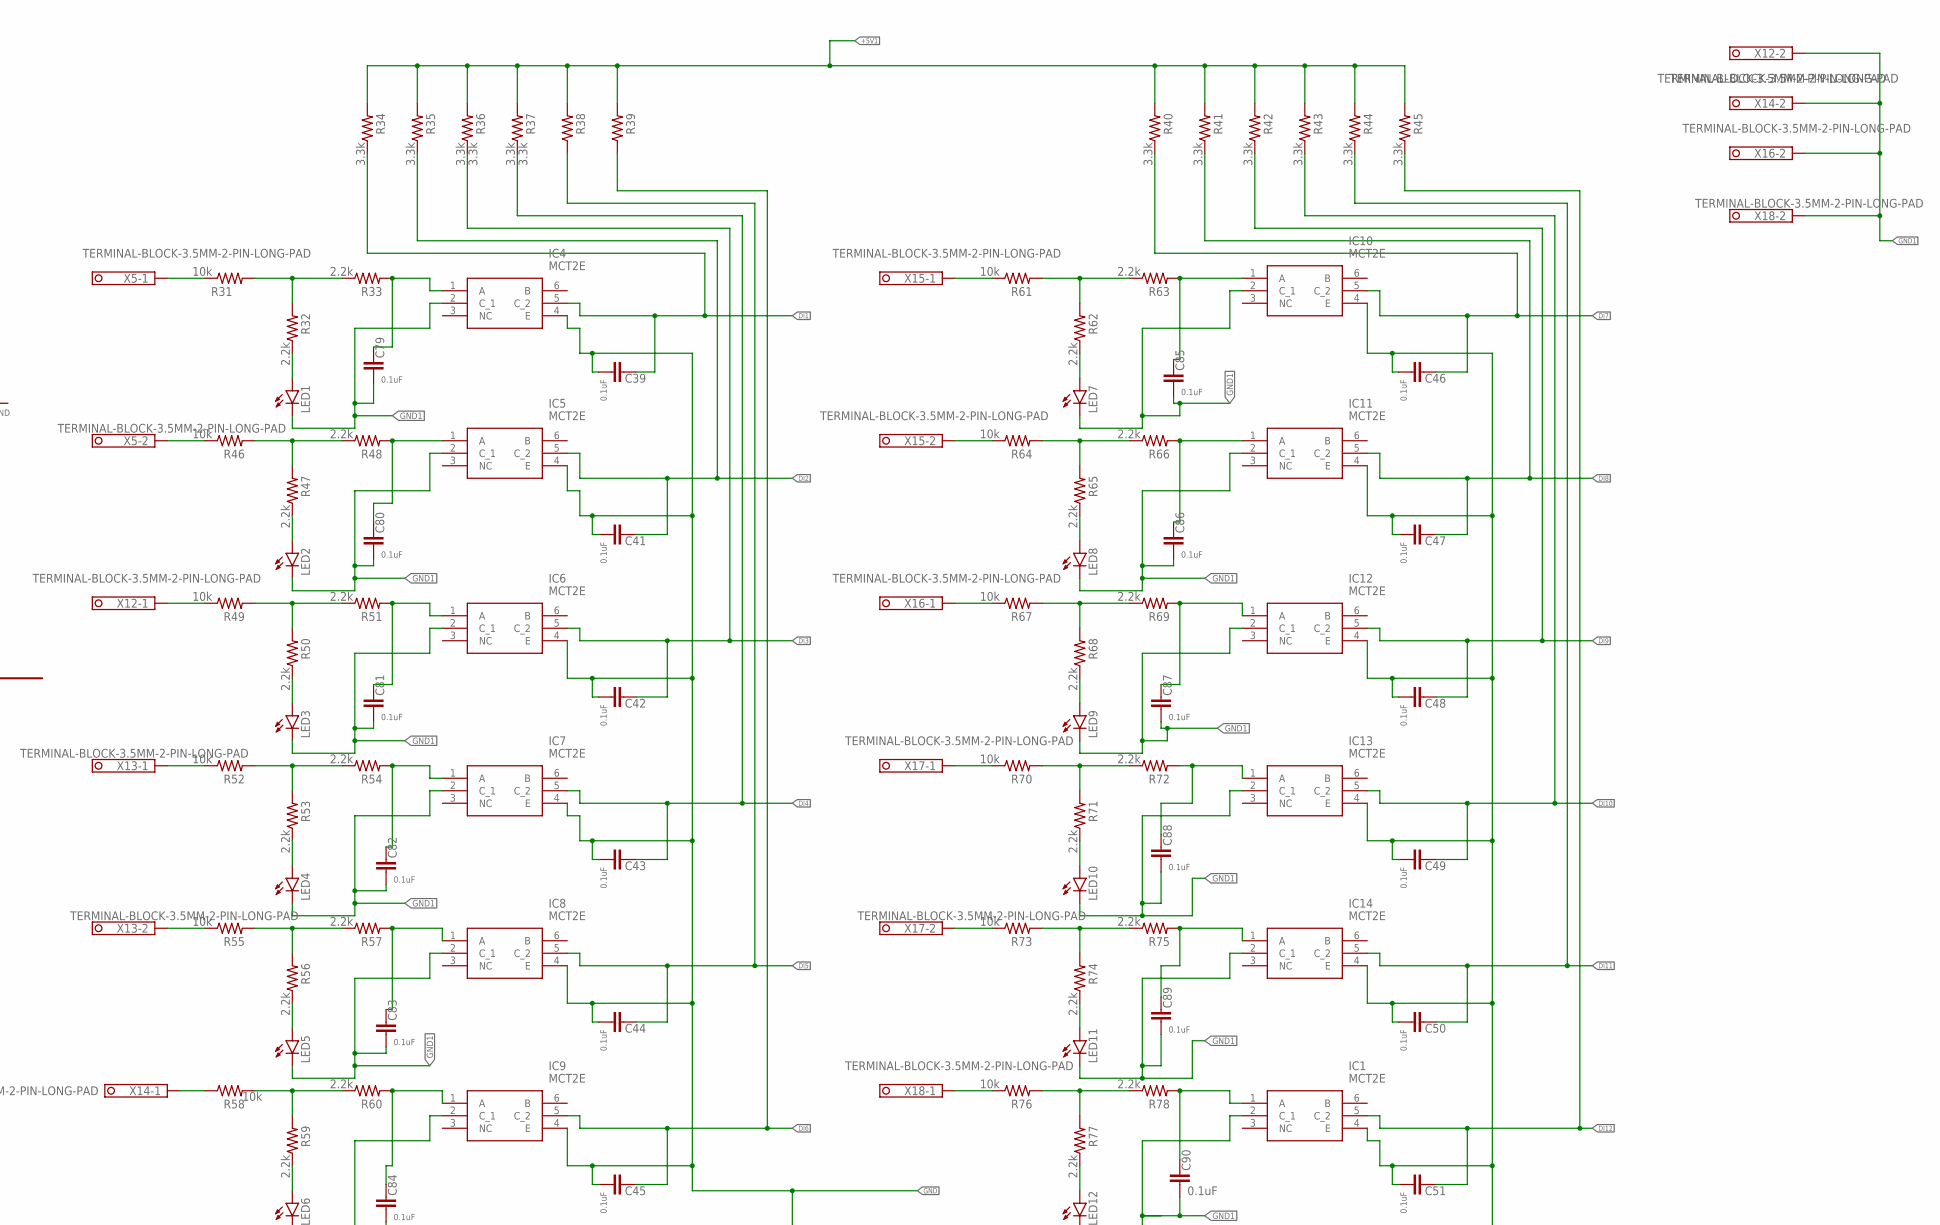
[picture p5: schematic Motherboard Schematics - 1 - 29_Dec_2020.sch, part in row 1, column 2]

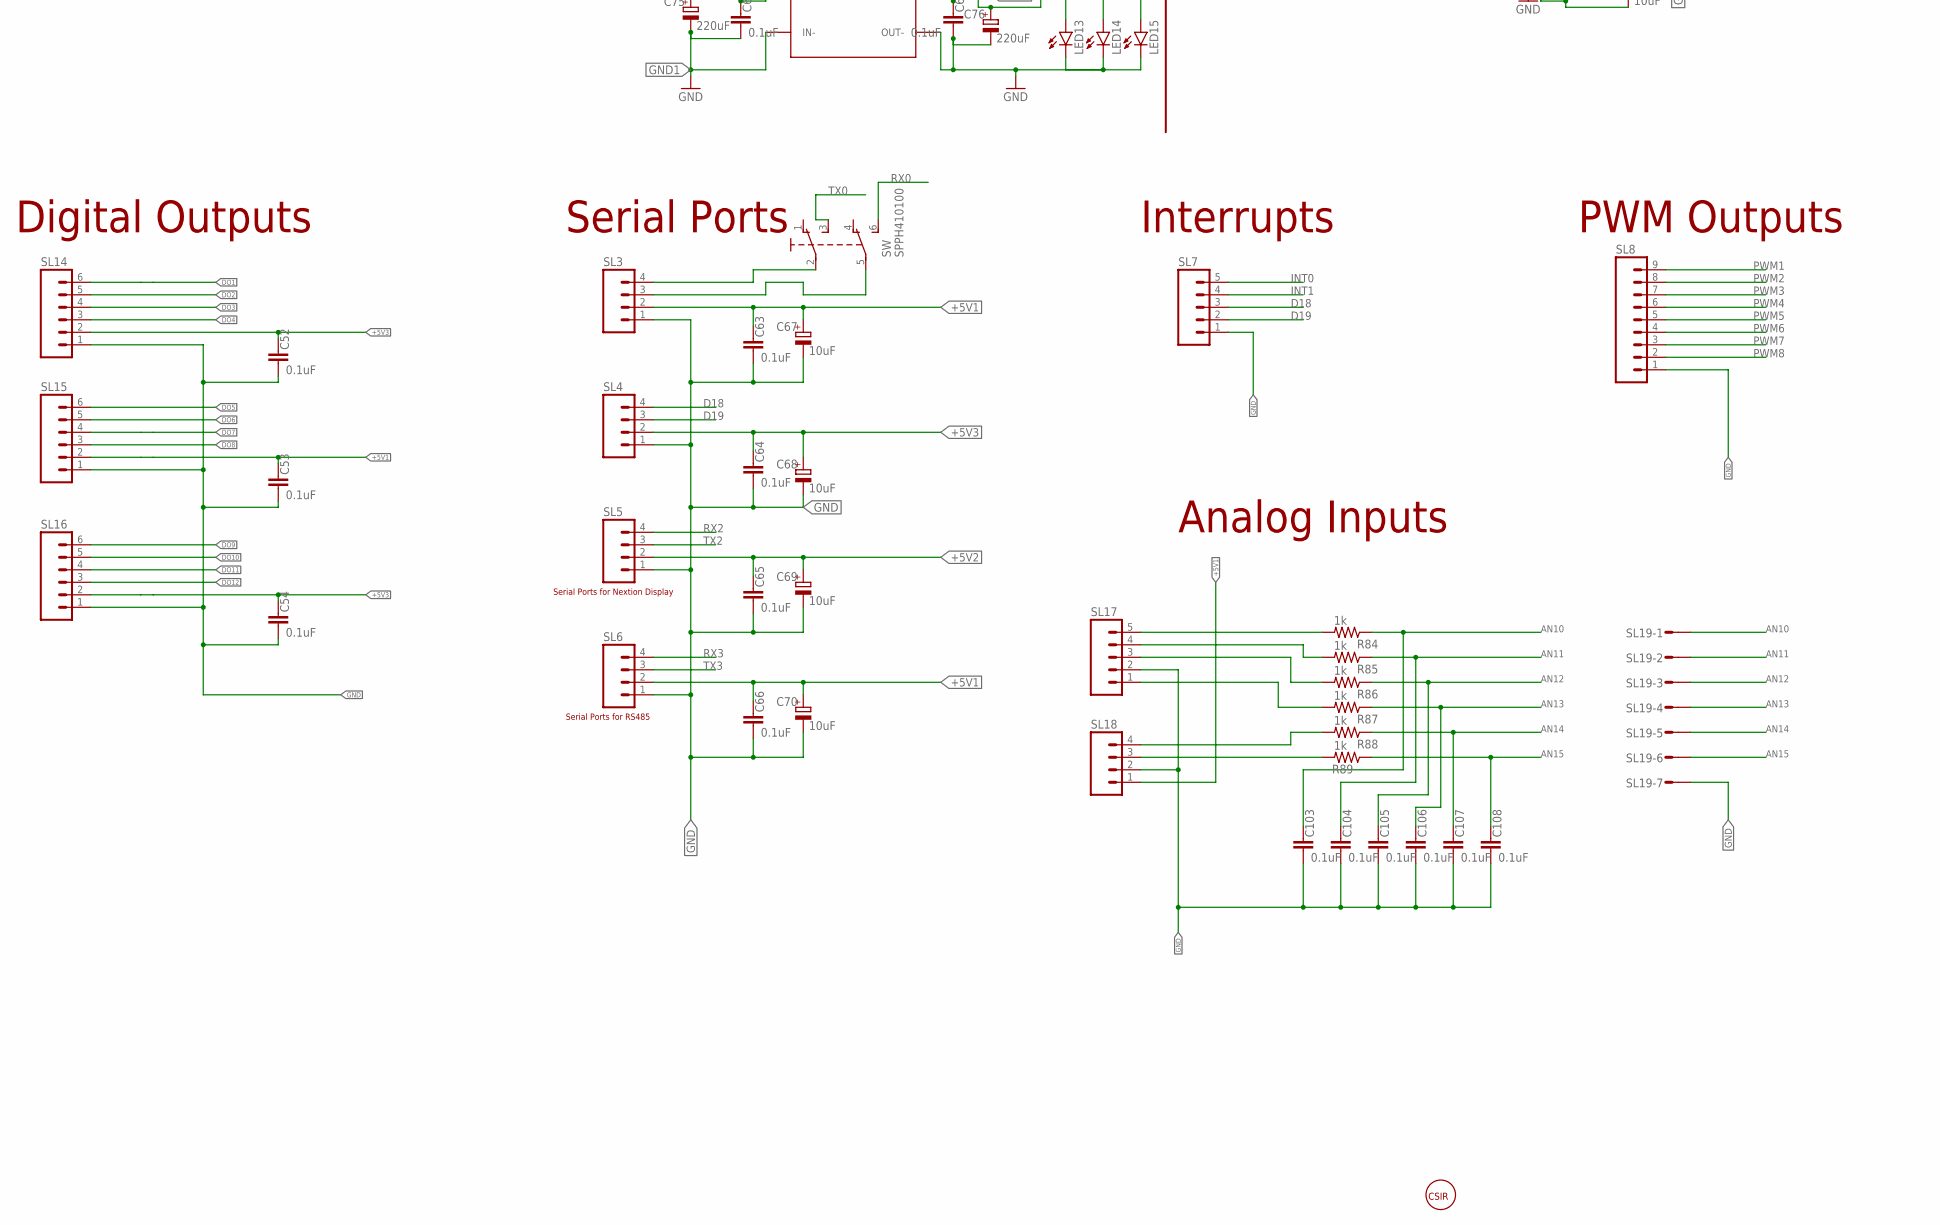
[picture p6: schematic Motherboard Schematics - 1 - 29_Dec_2020.sch, part in row 2, column 1]

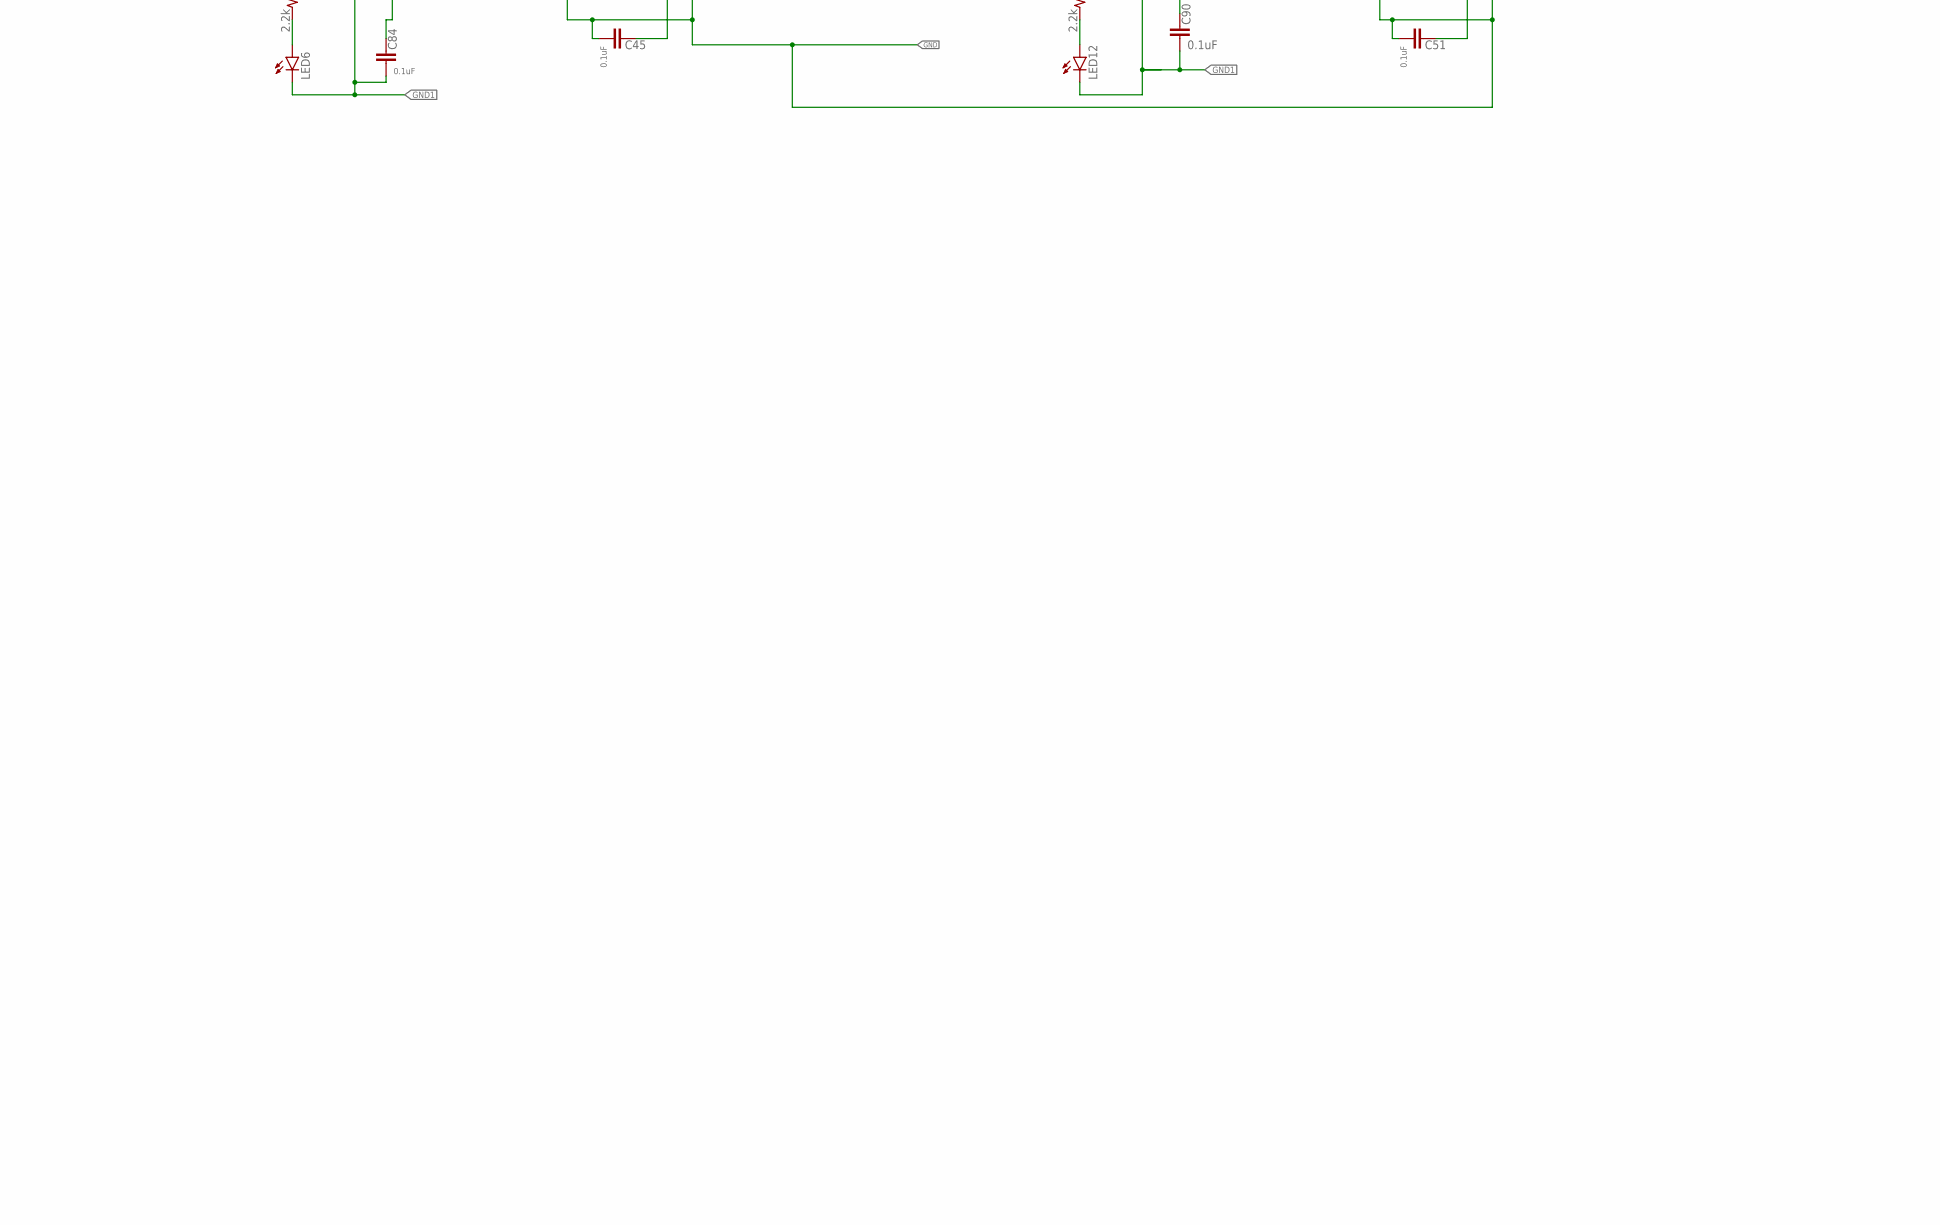
[picture p7: schematic Motherboard Schematics - 1 - 29_Dec_2020.sch, part in row 2, column 2]

Parts:
C1, C2, C3, C4, C5, C6, C7, C8, C9, C10, C11, C12, C13, C14, C15, C16, C17, C18, C19, C20, C21, C22, C23, C24, C25, C26, C27, C28, C29, C30, C33, C34, C35, C37, C38, C39, C41, C42, C43, C44, C45, C46, C47, C48, C49, C50, C51, C52, C53, C54, C55, C56, C59, C61, C62, C63, C64, C65, C66, C73, C74, C78, C79, C80, C81, C82, C83, C84, C85, C86, C87, C88, C89, C90, C103, C104, C105, C106, C107, C108: 0.1uF; C1206
C31, C72: 1000uF; E7,5-16
C32, C36, C40, C60, C75, C76, C77: 220uF; E5-10,5
C57, C58, C67, C68, C69, C70, C71: 10uF; E2,5-7
D1, D2, D3, D4, D5, D6, D7, D8, D9, D10, D11, D12, D13, D14., D15, D16, D17, D18, D19, D20: 1N4148W; DO214AC
FUSE: SH22,5A
IC1, IC4, IC5, IC6, IC7, IC8, IC9, IC10, IC11, IC12, IC13, IC14: MCT2E; DIP762W60P254L712H480Q6N
IC2, IC3: 7805DT; TO252
LED1, LED2, LED3, LED4, LED5, LED6, LED7, LED8, LED9, LED10, LED11, LED12, LED13, LED14, LED15, LED16: LEDCHIPLED_1206; CHIPLED_1206
MOD1: CARD-SD-ADAPTER-CATALEX
R, R1, R2, R3, R4, R5, R6, R7, R8, R9, R11, R12, R13, R14, R15, R16, R17, R18, R19, R20, R79, R80, R81, R82, R83, R84, R85, R86, R87, R88, R89: 1k; R1206
R10, R31, R46, R49, R52, R55, R58, R61, R64, R67, R70, R73, R76: 10k; R1206
R21, R22, R23, R24, R25, R26, R27, R28, R29, R30: 220; R1206
R32, R33, R47, R48, R50, R51, R53, R54, R56, R57, R59, R60, R62, R63, R65, R66, R68, R69, R71, R72, R74, R75, R77, R78: 2.2k; R1206
R34, R35, R36, R37, R38, R39, R40, R41, R42, R43, R44, R45: 3.3k; R1206
RESET_SW: 10-XX; B3F-10XX
SL1: M10S; 10P
SL2, SL13: M02; 02P
SL3, SL4, SL5, SL6, SL18: M04; 04P
SL7, SL17: M05; 05P
SL8: M09; 09P
SL9: M03S; 03P
SL10: M02S; 02P
SL14, SL15, SL16: M06; 06P
SL19: M07S; 07P
SW: SPPH410100
SWITCH: SWITCH_I
T1: TERMINAL_BLOCK; BOC_TERMINAL
U1: MEGA_PRO_EMBED_CH340G_/_ATMEGA2560; MODULE_MEGA_PRO_EMBED_CH340G_/_ATMEGA2560
U$1: RTC-DS3231-AT24C32
U$2: RS485-TTL-CONVERTER
U$3, U$4: DC-DC-STEP-DOWN-LM2596
U$5: CSIR_LOGO
X1, X2, X3, X6, X7, X8, X9, X10, X11: 5mmTerminal_Block; TERMINAL-BLOCK-2-PIN-3.5MM-LONG-PAD
X5, X12, X13, X14, X15, X16, X17, X18: TERMINAL-BLOCK-3.5MM-2-PIN-LONG-PAD; TERMINAL-BLOCK-2-PIN-3.5MM-LONG-PAD

Connections:
3.3V: SL9.2, U1.3V3_1 (3V3), U1.3V3_2 (3V3)
5V: R10.2, SL9.1, SL10.1, U1.5V_1 (5V), U1.5V_2 (5V), U1.5V_3 (5V), U1.AREF
+5V1: C1.1, C2.1, C3.1, C4.1, C5.1, C6.1, C7.1, C8.1, C9.1, C10.1, C35.1, C36.+, C53.1, C55.1, C56.1, C57.+, C58.+, C59.1, C63.1, C66.1, C67.+, C70.+, C71.+, D1.C, D2.C, D3.C, D4.C, D5.C, D6.C, D7.C, D8.C, D9.C, D10.C, IC2.2 (VO), MOD1.VCC5V (5V), R34.2, R35.2, R36.2, R37.2, R38.2, R39.2, R40.2, R41.2, R42.2, R43.2, R44.2, R45.2, R79.2, SL3.2, SL6.2, SL15.2, SL18.1, U$1.J1.5 (VCC.1), U$2.J2.1 (VCC)
+5V2: C38.1, C60.+, C65.1, C69.+, IC3.2 (VO), R80.2, SL5.2
+5V3: C52.1, C54.1, C62.1, C64.1, C68.+, C76.+, R81.2, SL4.2, SL14.2, SL16.2, U$4.OUT+
+9V1: C31.+, C32.+, C33.1, C34.1, C37.1, C40.+, C77.+, C78.1, IC2.1 (VI), IC3.1 (VI), R83.2, U1.VIN_1 (VIN), U1.VIN_2 (VIN), U$3.OUT+
+24V: SWITCH.P$3, T1.P$2, X1.1, X3.1
A: SL2.1, U$2.J2.3 (A)
AN0: C21.1, R11.2, SL1.1, U1.A0
AN1: C22.1, R12.2, SL1.2, U1.A1
AN2: C23.1, R13.2, SL1.3, U1.A2
AN3: C24.1, R14.1, SL1.4, U1.A3
AN4: C25.1, R15.1, SL1.5, U1.A4
AN5: C26.1, R16.2, SL1.6, U1.A5
AN6: C27.1, R17.2, SL1.7, U1.A6
AN7: C28.1, R18.2, SL1.8, U1.A7
AN8: C29.1, R19.2, SL1.9, U1.A8
AN9: C30.1, R20.2, SL1.10, U1.A9
AN10: C103.1, R84.1, SL19.1, U1.A10
AN11: C104.1, R85.1, SL19.2, U1.A11
AN12: C105.1, R86.1, SL19.3, U1.A12
AN13: C106.1, R87.1, SL19.4, U1.A13
AN14: C107.1, R88.1, SL19.5, U1.A14
AN15: C108.1, R89.1, SL19.6, U1.A15
B: SL2.2, U$2.J2.2 (B)
CS_SD: MOD1.CS, U1.D53
D18: SL4.4, SL7.3, U1.D18
D19: SL4.3, SL7.2, U1.D19
D46: U1.D46, U$2.J1.2 (DE), U$2.J1.3 (RE)
DI1: C39.1, IC4.5 (C_2), R34.1, U1.D22
DI2: C41.1, IC5.5 (C_2), R35.1, U1.D23
DI3: C42.1, IC6.5 (C_2), R36.1, U1.D24
DI4: C43.1, IC7.5 (C_2), R37.1, U1.D25
DI5: C44.1, IC8.5 (C_2), R38.1, U1.D26
DI6: C45.1, IC9.5 (C_2), R39.1, U1.D27
DI7: C46.1, IC10.5 (C_2), R40.1, U1.D28
DI8: C47.1, IC11.5 (C_2), R41.1, U1.D29
DI9: C48.1, IC12.5 (C_2), R42.1, U1.D30
DI10: C49.1, IC13.5 (C_2), R43.1, U1.D31
DI11: C50.1, IC14.5 (C_2), R44.1, U1.D32
DI12: C51.1, IC1.5 (C_2), R45.1, U1.D33
DO1: SL14.6, U1.D34
DO2: SL14.5, U1.D35
DO3: SL14.4, U1.D36
DO4: SL14.3, U1.D37
DO5: SL15.6, U1.D38
DO6: SL15.5, U1.D39
DO7: SL15.4, U1.D40
DO8: SL15.3, U1.D41
DO9: SL16.6, U1.D42
DO10: SL16.5, U1.D43
DO11: SL16.4, U1.D44
DO12: SL16.3, U1.D45
GND: C21.2, C22.2, C23.2, C24.2, C25.2, C26.2, C27.2, C28.2, C29.2, C30.2, C31.-, C32.-, C33.2, C34.2, C35.2, C36.-, C37.2, C38.2, C39.2, C40.-, C41.2, C42.2, C43.2, C44.2, C45.2, C46.2, C47.2, C48.2, C49.2, C50.2, C51.2, C52.2, C53.2, C54.2, C55.2, C56.2, C57.-, C58.-, C59.2, C60.-, C62.2, C63.2, C64.2, C65.2, C66.2, C67.-, C68.-, C69.-, C70.-, C71.-, C74.2, C76.-, C77.-, C78.2, C103.2, C104.2, C105.2, C106.2, C107.2, C108.2, IC1.4 (E), IC2.3 (GND), IC3.3 (GND), IC4.4 (E), IC5.4 (E), IC6.4 (E), IC7.4 (E), IC8.4 (E), IC9.4 (E), IC10.4 (E), IC11.4 (E), IC12.4 (E), IC13.4 (E), IC14.4 (E), LED13.C, LED14.C, LED15.C, LED16.C, MOD1.GND, R21.1, R22.1, R23.1, R24.1, R25.1, R26.1, R27.1, R28.1, R29.1, R30.1, RESET_SW.3, SL3.1, SL4.1, SL5.1, SL6.1, SL7.1, SL8.1, SL9.3, SL10.2, SL13.1, SL14.1, SL15.1, SL16.1, SL17.2, SL18.2, SL19.7, U1.GND_1 (GND), U1.GND_2 (GND), U1.GND_3 (GND), U$1.J1.6 (GND.1), U$2.J2.4 (GND), U$3.OUT-, U$4.OUT-, X1.2, X3.2, X7.1, X8.1, X10.2, X11.2
GND1: C61.2, C72.-, C73.2, C75.-, C79.2, C80.2, C81.2, C82.2, C83.2, C84.2, C85.2, C86.2, C87.2, C88.2, C89.2, C90.2, IC1.2 (C_1), IC4.2 (C_1), IC5.2 (C_1), IC6.2 (C_1), IC7.2 (C_1), IC8.2 (C_1), IC9.2 (C_1), IC10.2 (C_1), IC11.2 (C_1), IC12.2 (C_1), IC13.2 (C_1), IC14.2 (C_1), LED1.C, LED2.C, LED3.C, LED4.C, LED5.C, LED6.C, LED7.C, LED8.C, LED9.C, LED10.C, LED11.C, LED12.C, T1.P$1, U$3.IN-, U$4.IN-, X12.2, X14.2, X16.2, X18.2
GND.2: U$1.J2.4 (GND.2)
INT0: SL7.5, U1.D2
INT1: SL7.4, U1.D3
MISO: MOD1.MISO, U1.D50
MOSI: MOD1.MOSI, U1.D51
unnamed: C11.2, C12.2, C13.2, C14.2, C15.2, C16.2, C17.2, C18.2, C19.2, C20.2, D11.A, D12.A, D13.A, D14..A, D15.A, D16.A, D17.A, D18.A, D19.A, D20.A
unnamed: R2.1, R22.2, X6.1
unnamed: R3.1, R23.2, X7.2
unnamed: R4.1, R24.2, X8.2
unnamed: R52.1, X13.1
unnamed: R58.1, X14.1
unnamed: R5.1, R25.2, X9.2
unnamed: R6.1, R26.2, X9.1
unnamed: R7.1, R27.2, X10.1
unnamed: R8.1, R28.2, X11.1
unnamed: R9.1, R30.2, X2.1
unnamed: R1.1, R21.2, X6.2
unnamed: FUSE.1, SWITCH.P$1
unnamed: R82.1, U1.RESET
unnamed: R.1, R29.2, X2.2
unnamed: R31.1, X5.1
unnamed: R31.2, R32.2, R33.1
unnamed: C79.1, IC4.1 (A), R33.2
unnamed: LED1.A, R32.1
unnamed: R55.1, X13.2
unnamed: R46.1, X5.2
unnamed: C88.1, IC13.1 (A), R72.2
unnamed: R46.2, R47.2, R48.1
unnamed: C80.1, IC5.1 (A), R48.2
unnamed: LED2.A, R47.1
unnamed: R73.1, X17.2
unnamed: R70.1, X17.1
unnamed: R49.1, X12.1
unnamed: R49.2, R50.2, R51.1
unnamed: C81.1, IC6.1 (A), R51.2
unnamed: LED3.A, R50.1
unnamed: R61.1, X15.1
unnamed: R61.2, R62.2, R63.1
unnamed: R64.1, X15.2
unnamed: R52.2, R53.2, R54.1
unnamed: C82.1, IC7.1 (A), R54.2
unnamed: LED4.A, R53.1
unnamed: C85.1, IC10.1 (A), R63.2
unnamed: R84.2, SL17.5
unnamed: SL3.4, SW.2
unnamed: C61.1, C72.+, C73.1, C75.+, FUSE.2, U$3.IN+, U$4.IN+
unnamed: C74.1, R10.1, R82.2, RESET_SW.2 (S1), SL13.2
unnamed: R55.2, R56.2, R57.1
unnamed: C83.1, IC8.1 (A), R57.2
unnamed: LED5.A, R56.1
unnamed: LED7.A, R62.1
unnamed: R58.2, R59.2, R60.1
unnamed: C84.1, IC9.1 (A), R60.2
unnamed: LED6.A, R59.1
unnamed: R85.2, SL17.4
unnamed: R64.2, R65.2, R66.1
unnamed: C86.1, IC11.1 (A), R66.2
unnamed: LED8.A, R65.1
unnamed: R67.1, X16.1
unnamed: R67.2, R68.2, R69.1
unnamed: C87.1, IC12.1 (A), R69.2
unnamed: LED9.A, R68.1
unnamed: R70.2, R71.2, R72.1
unnamed: LED13.A, R79.1
unnamed: LED10.A, R71.1
unnamed: LED14.A, R80.1
unnamed: R73.2, R74.2, R75.1
unnamed: C89.1, IC14.1 (A), R75.2
unnamed: LED11.A, R74.1
unnamed: R76.2, R77.2, R78.1
unnamed: C90.1, IC1.1 (A), R78.2
unnamed: LED12.A, R77.1
unnamed: R76.1, X18.1
unnamed: LED15.A, R81.1
unnamed: SL3.3, SW.5 (P1)
unnamed: R86.2, SL17.3
unnamed: LED16.A, R83.1
unnamed: R87.2, SL17.1
unnamed: R88.2, SL18.4
unnamed: R89.2, SL18.3
PWM1: SL8.9, U1.D6
PWM2: SL8.8, U1.D7
PWM3: SL8.7, U1.D8
PWM4: SL8.6, U1.D9
PWM5: SL8.5, U1.D10
PWM6: SL8.4, U1.D11
PWM7: SL8.3, U1.D12
PWM8: SL8.2, U1.D13
RX0: SW.6 (S1), U1.RX
RX2: SL5.4, U1.D17
RX3: SL6.4, U1.D15, U$2.J1.4 (RO)
S0: C1.2, C11.1, D1.A, D11.C, R1.2, R11.1
S1: C2.2, C12.1, D2.A, D12.C, R2.2, R12.1
S2: C3.2, C13.1, D3.A, D13.C, R3.2, R13.1
S3: C4.2, C14.1, D4.A, D14..C, R4.2, R14.2
S4: C5.2, C15.1, D5.A, D15.C, R5.2, R15.2
S5: C6.2, C16.1, D6.A, D16.C, R6.2, R16.1
S6: C7.2, C17.1, D7.A, D18.C, R7.2, R17.1
S7: C8.2, C18.1, D8.A, D17.C, R8.2, R18.1
S8: C9.2, C19.1, D9.A, D19.C, R9.2, R19.1
S9: C10.2, C20.1, D10.A, D20.C, R.2, R20.1
SCK: MOD1.SCK, U1.D52
SCL: U1.D20, U$1.J1.3 (SCL.1)
SDA: U1.D21, U$1.J1.4 (SDA.1)
TX0: SW.3 (S), U1.TX
TX2: SL5.3, U1.D16
TX3: SL6.3, U1.D14, U$2.J1.1 (DI)
VCC.2: U$1.J2.3 (VCC.2)

Notes on the sheet:
Analog Section
Power Supply Section
Digital Outputs
Peripherals
Serial Ports
Interrupts
PWM Outputs
Serial Ports for Nextion Display
Serial Ports for RS485
Analog Inputs

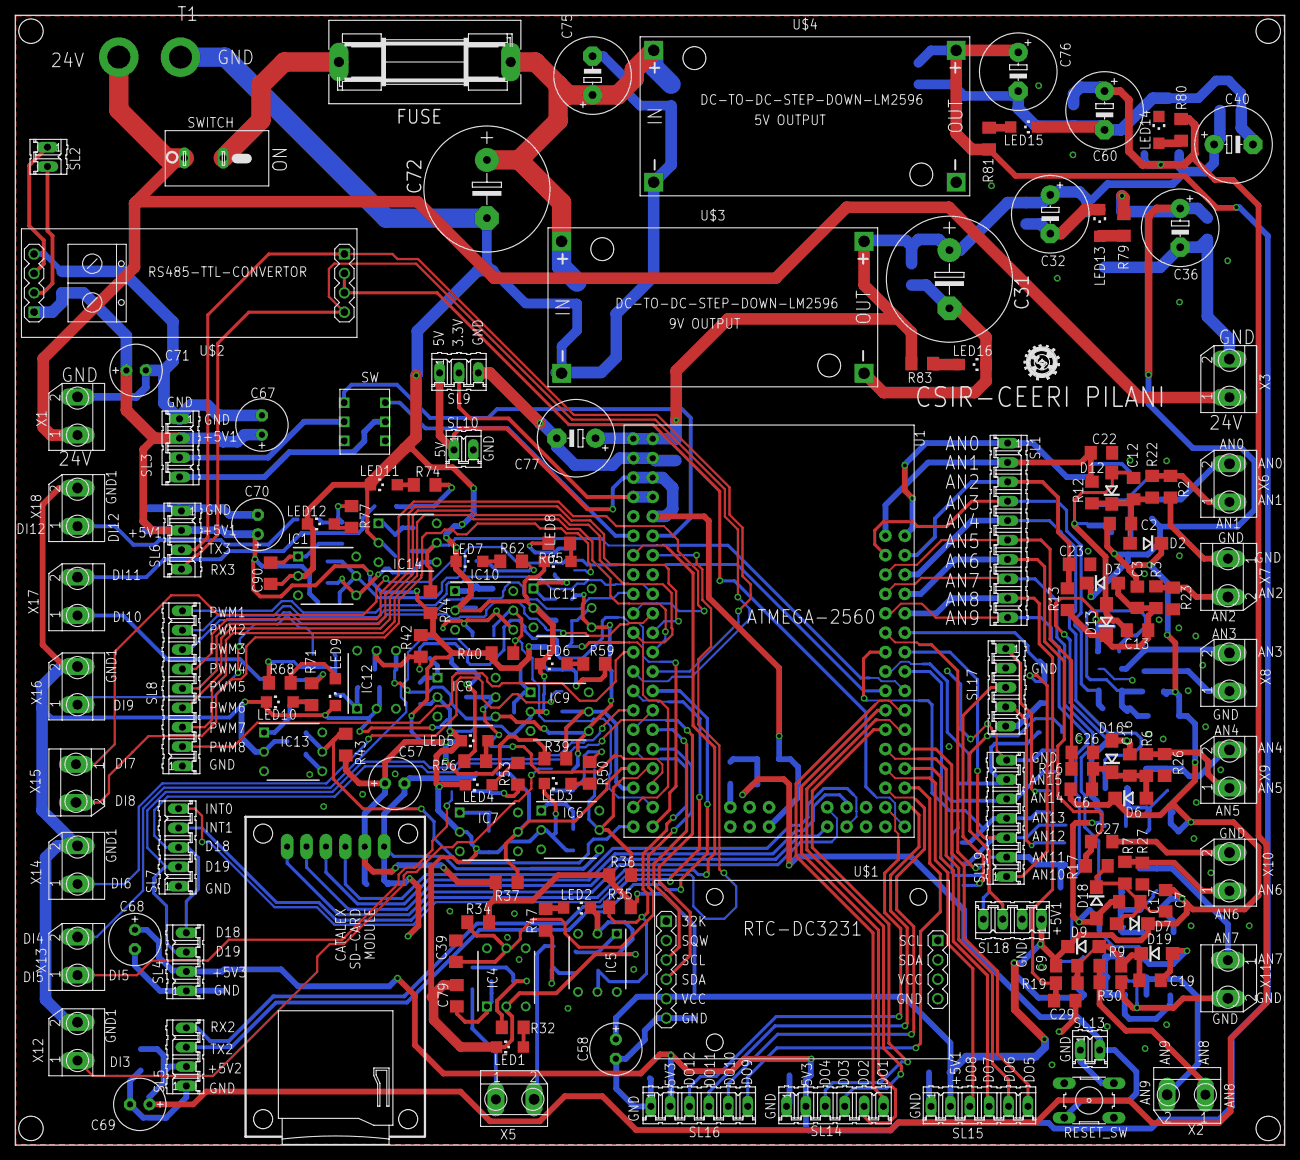
[picture p8: board Motherboard Schematics - 1 - 29_Dec_2020.brd from above]

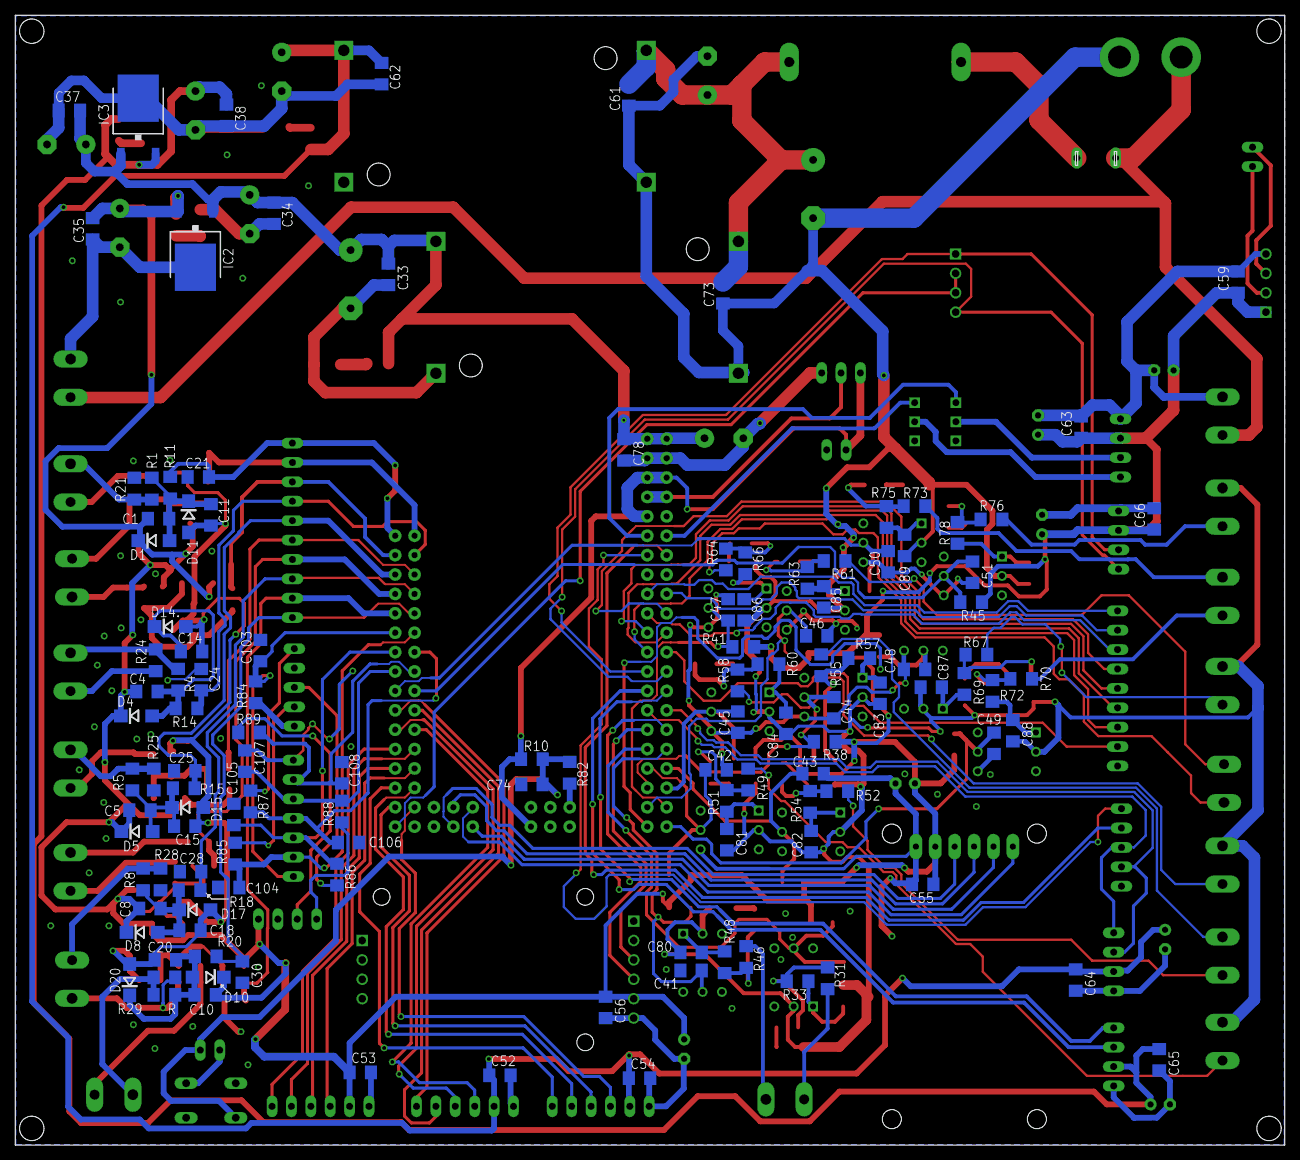
[picture p9: board Motherboard Schematics - 1 - 29_Dec_2020.brd from below]

Board: 2 copper layers, 166.3 x 148.0 mm, 282 parts (124 on the bottom side), 161 nets.
