nit1995/reimagined-enigma/(commit log)

2021-03-15 Create M3.ino
    Addition of pH Meter, Conductivity Meter and Level Sensors to M2.
2021-03-15 Add Sensors to M2
    Integrate pH Meter, Conductivity Meter and Level Sensor
2021-03-16 Create i2cscanner.ino
    To find the I2C address of devices connected.
2021-03-16 Schematics for EMCS
    [BOM 28-1-21.csv, Motherboard Schematics - 1 - 29_Dec_2020.brd, Motherboard Schematics - 1 - 29_Dec_2020.sch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]
2021-03-23 Create Power Supply.md
2021-03-31 Added relay operation to level switch
2021-06-29 Add float sensors
    Program to read all 10 Magnetic Float Sensors to be installed in Lodhva and store the data in an SD Card with the timestamp. Added all 10 float sensors from LAH-001 to LAH-006 and LAL-001 to LAL-005
2021-06-30 Create M6.ino
    Code to implement Conductivity Sensors in EMCS and write in SD Card
2021-07-26 Create M5.ino
    Fixed the return level issue
    [M5.ino]
2021-07-27 Update M6.ino
    Correction of measure_conductivity() function by adding input of analog pins
    [M6.ino]
